mickle1919/partial_weight_bearing_insole/Code/README.md

# Code

These folders contain various code I used throughout the project.

All of the code was prompted from Claude. I then tested it on the hardware through the Arduino IDE, except for the MATLAB scripts, which I ran myself on the lab data.

Because I worked in the Arduino IDE, editing one sketch over and over, there is no real version control history for this project. So instead of a commit history, I have tried to include the separate files for each iteration
