mickle1919/partial_weight_bearing_insole/Prototype Data/Foam Calibration Data.csv

 |  | 10 lb |  |  |  |  | 15 lb |  |  |  |  | 20 lb |  |  |  |  | 25 lb |  |  |  |  | 30 lb |  |  |  |  | 35 lb |  |  |  |  | 40 lb |  |  |  |  | 45 lb |  |  |  |  | 50 lb |  |  |  |  | 55 lb
Time (ms) | Trial 1 | Trial 2 | Trial 3 | Average | Time (ms) | Trial 1 | Trial 2 | Trial 3 | Average | Time (ms) | Trial 1 | Trial 2 | Trial 3 | Average | Time (ms) | Trial 1 | Trial 2 | Trial 3 | Average | Time (ms) | Trial 1 | Trial 2 | Trial 3 | Average | Time (ms) | Trial 1 | Trial 2 | Trial 3 | Average | Time (ms) | Trial 1 | Trial 2 | Trial 3 | Average | Time (ms) | Trial 1 | Trial 2 | Trial 3 | Average | Time (ms) | Trial 1 | Trial 2 | Trial 3 | Average | Time (ms) | Trial 1 | Trial 2 | Trial 3 | Average
0 | 1012 | 1010 | 1011 | 1011 | 0 | 1000 | 1008 | 1006 | 1004.7 | 0 | 1005 | 1000 | 985 | 996.7 | 0 | 998 | 964 | 980 | 980.7 | 0 | 973 | 966 | 944 | 961 | 0 | 979 | 969 | 957 | 968.3 | 0 | 919 | 946 | 889 | 918 | 0 | 912 | 900 | 890 | 900.7 | 0 | 880 | 910 | 890 | 893.3 | 0 | 851 | 821 | 811 | 827.7
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
