mickle1919/partial_weight_bearing_insole/Lab Data/stand on test foot only/my_data_stand_on_test_foot_only.csv

Trial | Time(ms) | Heel_avg | Heel_lb | Ball_avg | Ball_lb | Percent | Heel_raw | Ball_raw
1 | 5 | 442 | 37.8 | 786 | 16.5 | 119.4 | 443 | 786
1 | 24 | 441 | 38.0 | 782 | 16.7 | 120.7 | 442 | 781
1 | 42 | 441 | 38.0 | 784 | 16.6 | 120.3 | 442 | 784
1 | 62 | 441 | 38.0 | 782 | 16.7 | 120.7 | 442 | 783
1 | 80 | 441 | 38.0 | 782 | 16.7 | 120.7 | 442 | 781
1 | 98 | 441 | 38.0 | 781 | 16.7 | 120.8 | 442 | 781
1 | 118 | 442 | 37.8 | 784 | 16.6 | 119.7 | 443 | 784
1 | 136 | 443 | 37.6 | 788 | 16.4 | 118.4 | 444 | 787
1 | 155 | 443 | 37.6 | 776 | 17.0 | 120.4 | 444 | 776
1 | 174 | 444 | 37.4 | 768 | 17.4 | 121.2 | 445 | 767
1 | 193 | 445 | 37.2 | 781 | 16.7 | 118.3 | 446 | 780
1 | 211 | 445 | 37.2 | 779 | 16.8 | 118.7 | 446 | 779
1 | 231 | 445 | 37.2 | 778 | 16.9 | 118.8 | 446 | 777
1 | 249 | 445 | 37.2 | 779 | 16.8 | 118.7 | 445 | 778
1 | 268 | 445 | 37.2 | 780 | 16.8 | 118.5 | 446 | 780
1 | 287 | 446 | 37.0 | 779 | 16.8 | 118.1 | 446 | 779
1 | 305 | 445 | 37.2 | 780 | 16.8 | 118.5 | 446 | 780
1 | 325 | 444 | 37.4 | 779 | 16.8 | 119.3 | 444 | 779
1 | 343 | 443 | 37.6 | 779 | 16.8 | 119.9 | 444 | 778
1 | 362 | 442 | 37.8 | 779 | 16.8 | 120.5 | 443 | 779
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
