mickle1919/partial_weight_bearing_insole/Lab Data/analysis/sensor_calibration_trials.csv

sensor | level | trial | raw_reading | true_lb
heel | 25% | 1 | 421 | 45.0
heel | 25% | 2 | 412 | 48.2
heel | 25% | 3 | 444 | 42.1
heel | 50% | 1 | 328 | 78.9
heel | 50% | 2 | 318 | 89.2
heel | 50% | 3 | 321 | 78.8
heel | 75% | 1 | 283 | 112.3
heel | 75% | 2 | 285 | 109.3
heel | 75% | 3 | 300 | 111.9
heel | 100% | 1 | 244 | 164.0
heel | 100% | 2 | 229 | 162.4
heel | 100% | 3 | 228 | 162.9
ball | 25% | 1 | 649 | 47.3
ball | 25% | 2 | 620 | 34.8
ball | 25% | 3 | 614 | 38.2
ball | 50% | 1 | 531 | 79.3
ball | 50% | 2 | 541 | 71.3
ball | 50% | 3 | 512 | 73.3
ball | 75% | 1 | 339 | 115.6
ball | 75% | 2 | 358 | 113.3
ball | 75% | 3 | 303 | 112.8
ball | 100% | 1 | 371 | 159.8
ball | 100% | 2 | 289 | 157.2
ball | 100% | 3 | 378 | 167.0
