mickle1919/partial_weight_bearing_insole/Engineering Notebook/README.md

# Engineering Notebook

Documents in order:

1. **Research** - state of the art summary, existing PWB devices and sensing options
2. **Design Statement** - three proposed designs and the decision matrix
3. **Prototyping 1** - conductive foam vs FSR, resistor sweep, first calibration
4. **Prototyping 2** - foam drift vs leakage, foam-sandwich test, noise filters
5. **Prototyping 3** - two 150 kg FSRs on a 3D-printed insole, home calibration, first walking test
6. **Prototyping 4 (LAB)** - force plate validation at the Wolf Orthopaedic Biomechanics Laboratory
7. **Prototyping 5** - compacting the device: perfboard, battery, Bluetooth, alarm
8. **Lessons Learned** - summarizes the project so far, and what I have learned

NOTE: GitHub’s preview only loads the first few pages at a time. On the longer documents you’ll need to click the “More pages” button at the bottom of the preview to keep reading, or download the file to see the whole thing at once.
