mickle1919/partial_weight_bearing_insole/(commit log)

2026-10-17 Enhance README with project details and future plans
    Expanded project description and added details about the device's functionality and testing.
2026-10-17 Update README with Arduino sketch descriptions
    Added detailed descriptions of Arduino sketches used for conductive foam and FSR testing.
2026-10-18 Update README with lab session details and code explanations
    Added detailed information about the two-sensor insole and force plate session, including descriptions of the Arduino code files and their functionalities.
2026-10-26 Update README to include current device usage
    Added section detailing the current usage of '11_xiao_ble_limit_anchor.ino' and its functionality.
2026-11-02 Fix directory case for MATLAB analysis code
